jean-claudeF/Elektronische_Last/README.md

# Elektronische_Last
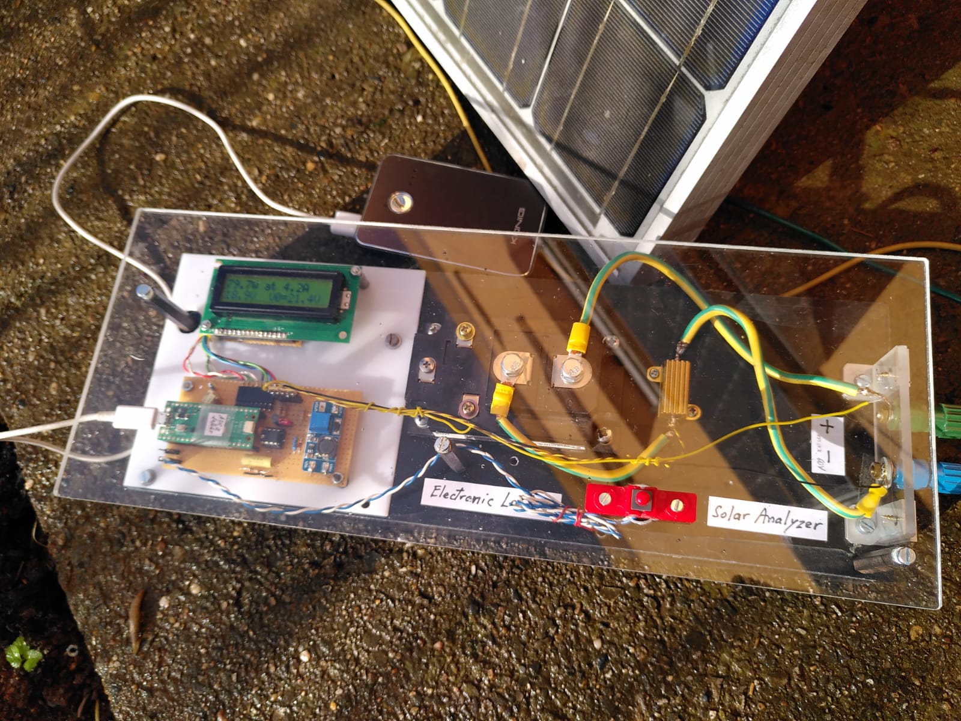
[picture p1: El_Last.jpg]

Elektronische Last zur Aufnahme von UI und PI - Kurven von Solarpaneln

## Verwendung:
- Standalone: LCD zeigt maximale Leistung, Spannung und Strom im MPP an
- Computergesteuert: Aufnahme der Kurven U = f(I) und P = f(I)
  (im Bild Testkurve Netzteil mit Innenwiderstand)

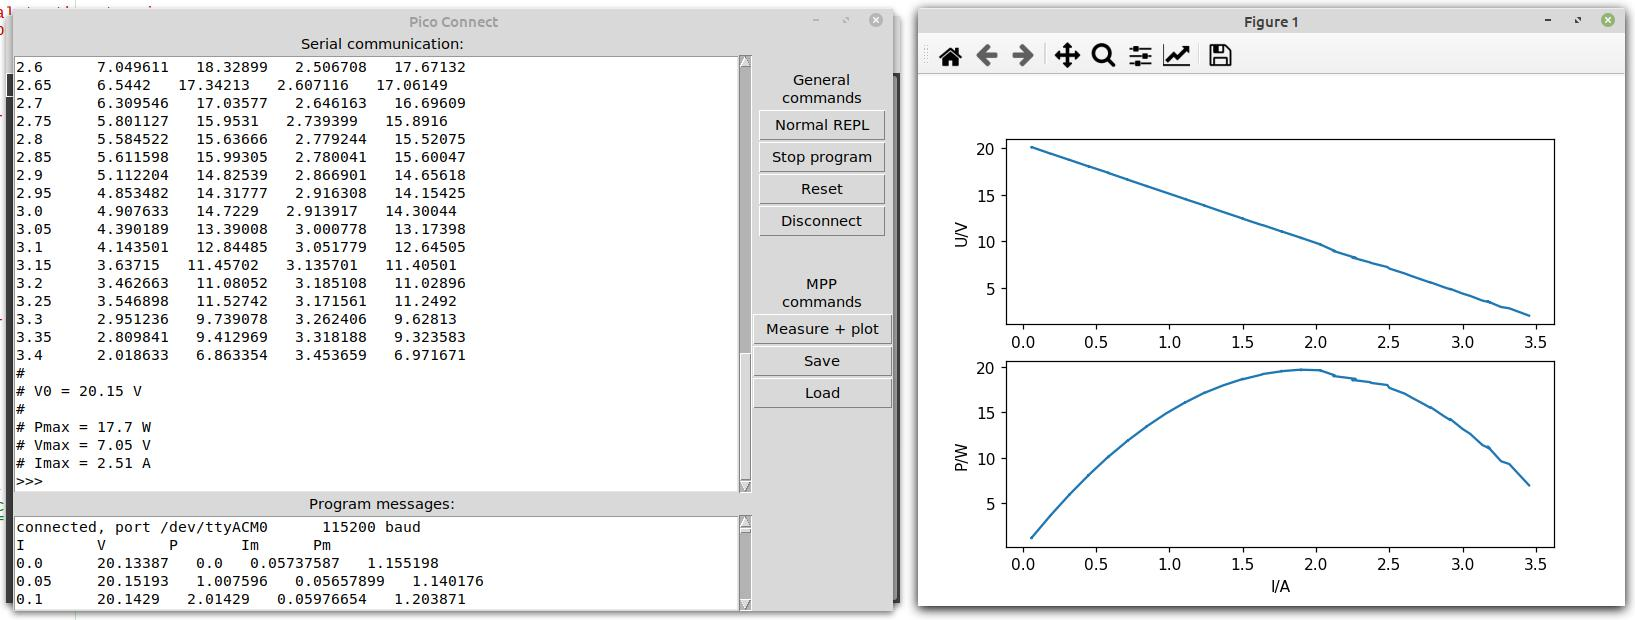
[picture p2: tk_el_load_py.jpg]


Doku im PDF
