jean-claudeF/Elektronische_Last/ElektronischeLast_02.sch

## KiCad design ElektronischeLast_02.sch (2023-10-20)

Schematic: ElektronischeLast_02.sch

Parts:
C1: 1n
C2: 10nF
C3: 100nF
J1: BAT+
J2: BAT-
Q1: 1MBI400NA-120-02; TO-247-3_Vertical
R1: 39k
R2, R7: 1k
R3, R5: 10k
R4: R22
R6: 18k
RV1: 10k
U1, U3: LM358
U2: Pico; RPi_Pico_SMD_TH

Notes on the sheet:
Manual set I
Software set I
Power supply Battery Solar panel
